ese3500/final-project-lineup/LineUp - Zwe Tun, Will Tun.pdf

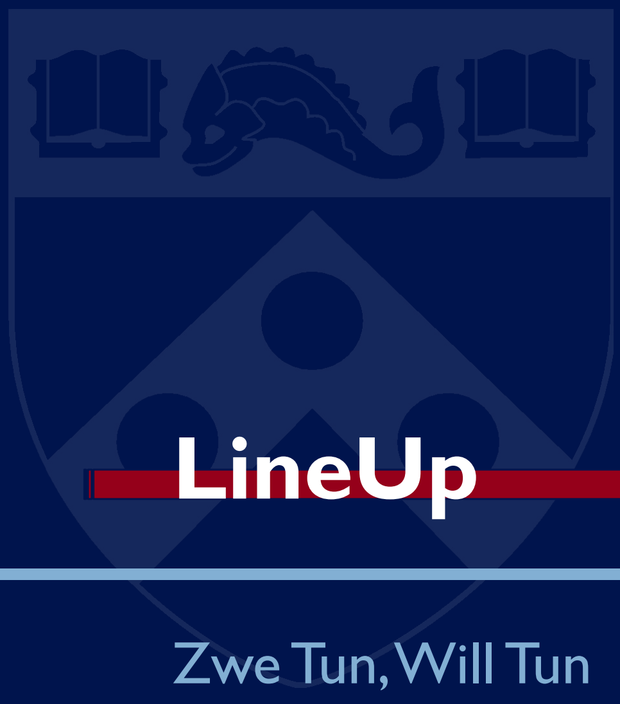
[picture p5: figure]
LineUp; Zwe Tun, Will Tun
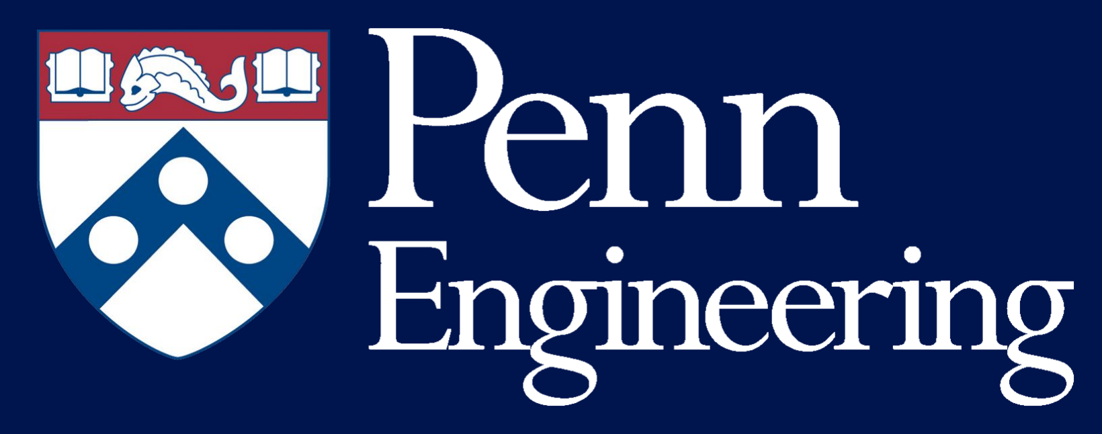
[picture p6: figure]

### Problem

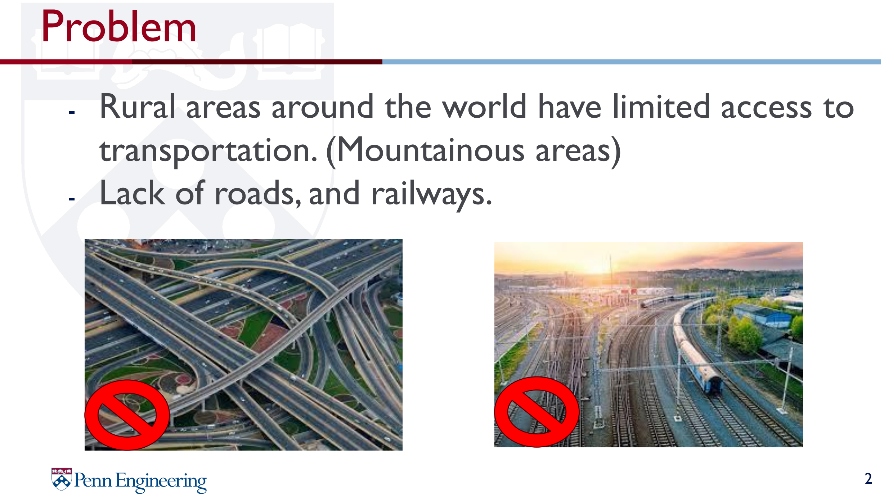
[picture p7: page 2]

- Rural areas around the world have limited access to transportation. (Mountainous areas)
- Lack of roads, and railways.

2

### Solution

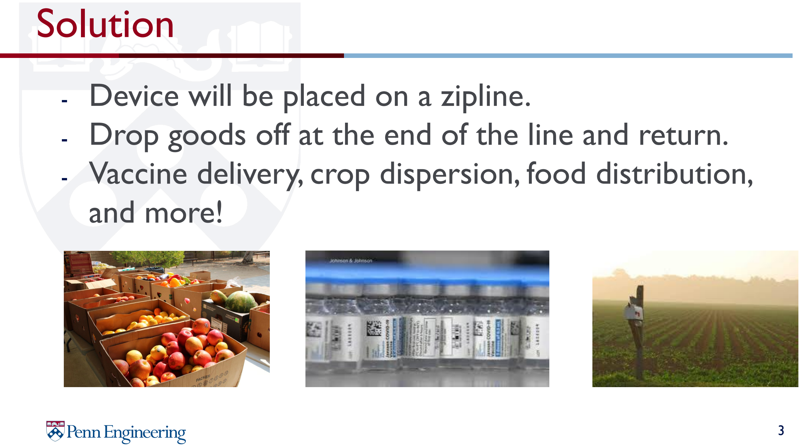
[picture p8: page 3]

- Device will be placed on a zipline.
- Drop goods off at the end of the line and return.
- Vaccine delivery, crop dispersion, food distribution, and more!

3

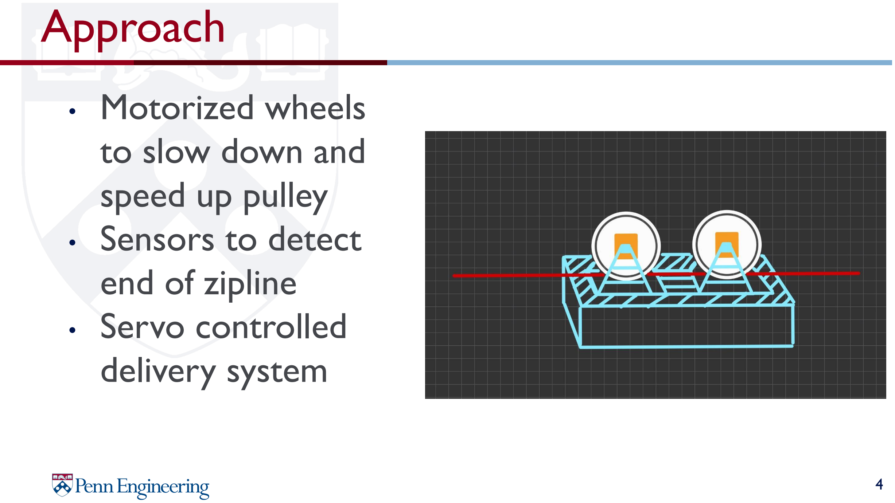
[picture p9: page 4]

Approach • Motorized wheels

to slow down and
speed up pulley
- Sensors to detect
end of zipline
- Servo controlled
delivery system

4

### Block Diagram

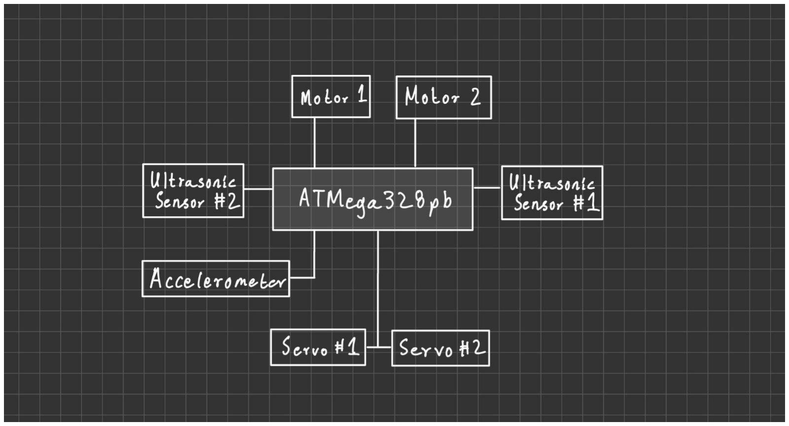
[picture p10: figure]

### Circuit Diagram

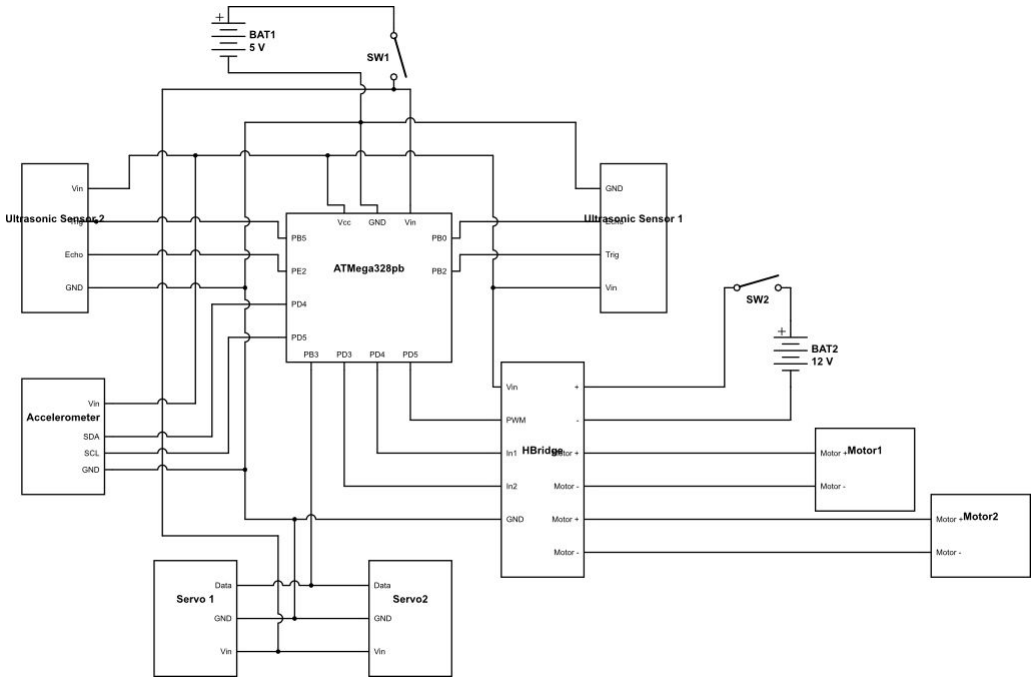
[picture p11: figure]

### Hardware Requirement

- 2 Servos.
- 2 Ultrasonic Sensors
- 2 Motors.
- Power Management

### Software Requirement

- Communication: I2C
- Timer: PWM
- Interrupts: Input Capture

### For the Future…

- Faster microcontroller.
- Stronger pulley system.
- 3D printed chassis.
- Lidar sensors.

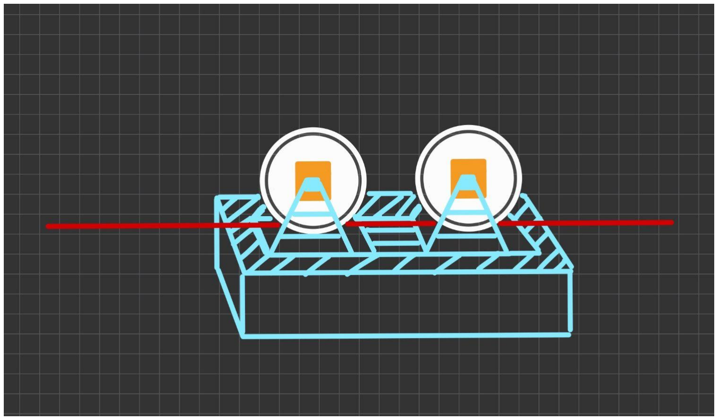
[picture p12: figure]
