ese3500/final-project-lineup/20240430_222514.jpg

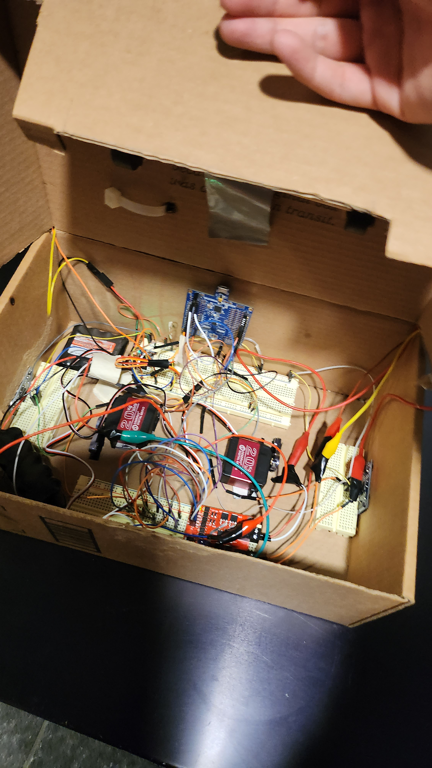
20240430_222514.jpg
