ese3500/final-project-lineup/(commit log)

2024-04-26 Update and rename I2C code.c to I2C code. (old)c
2024-04-26 Update and rename I2C.h to I2C(old).h
2024-05-01 Rename Circuit Diagram.png to Circuit_Diagram.png
